festlv/eggbot/stls/Pen_Arm_Top.stl

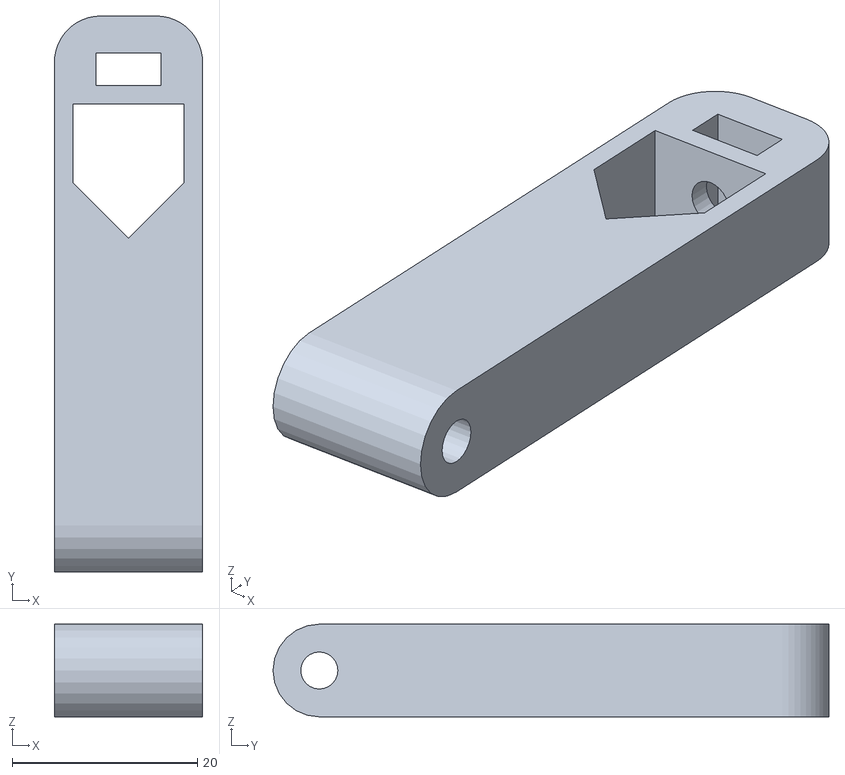
[picture p1: CAD file, 2014-04-03]
stls/Pen_Arm_Top.stl
16.0 x 60.0 x 10.0
