festlv/eggbot/stls/Pen_Arm_Pivot.stl

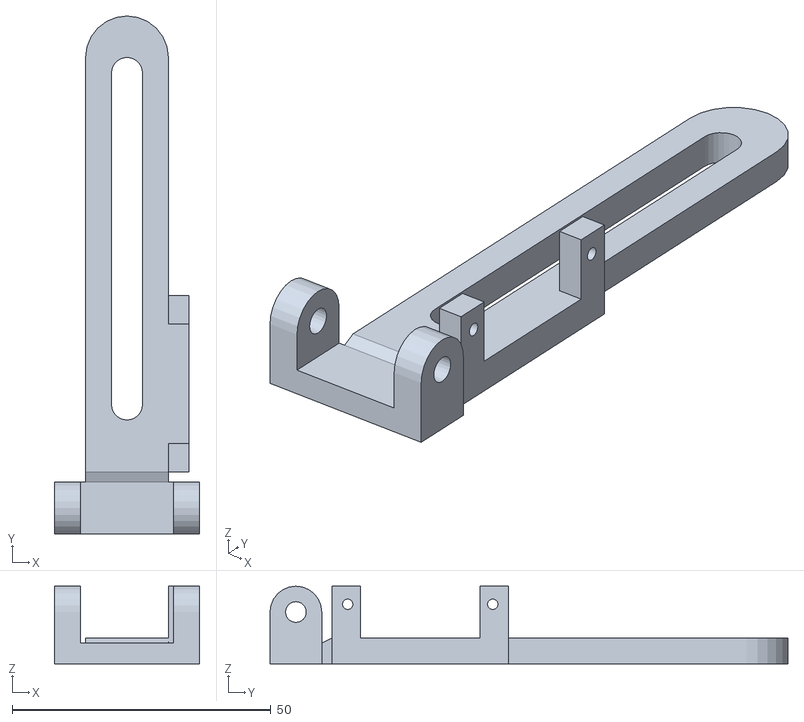
[picture p2: CAD file, 2014-04-03]
stls/Pen_Arm_Pivot.stl
28.0 x 100.0 x 15.0
