festlv/eggbot/stls/Idler_Bearing_Plate.stl

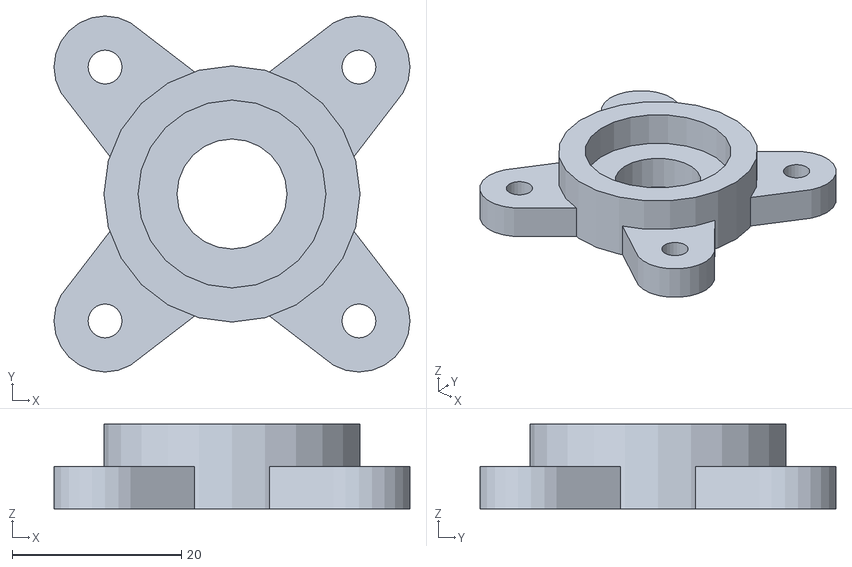
[picture p3: CAD file, 2014-04-03]
stls/Idler_Bearing_Plate.stl
42.1 x 42.1 x 10.0
