festlv/eggbot/stls/Idler_Knob.stl

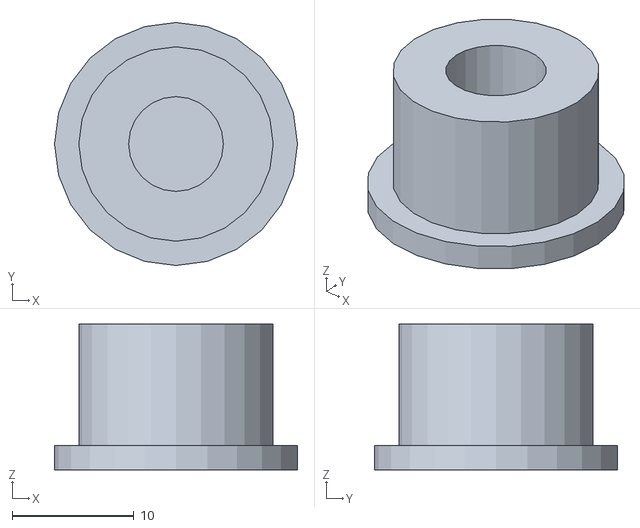
[picture p4: CAD file, 2014-04-03]
stls/Idler_Knob.stl
20.0 x 20.0 x 12.0
