festlv/eggbot/stls/Back_Plate.stl

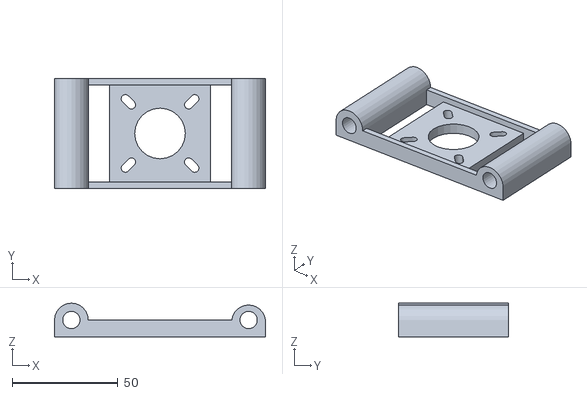
[picture p5: CAD file, 2014-04-03]
stls/Back_Plate.stl
100.0 x 52.0 x 16.0
