festlv/eggbot/stls/Egg_Cup_Idle.stl

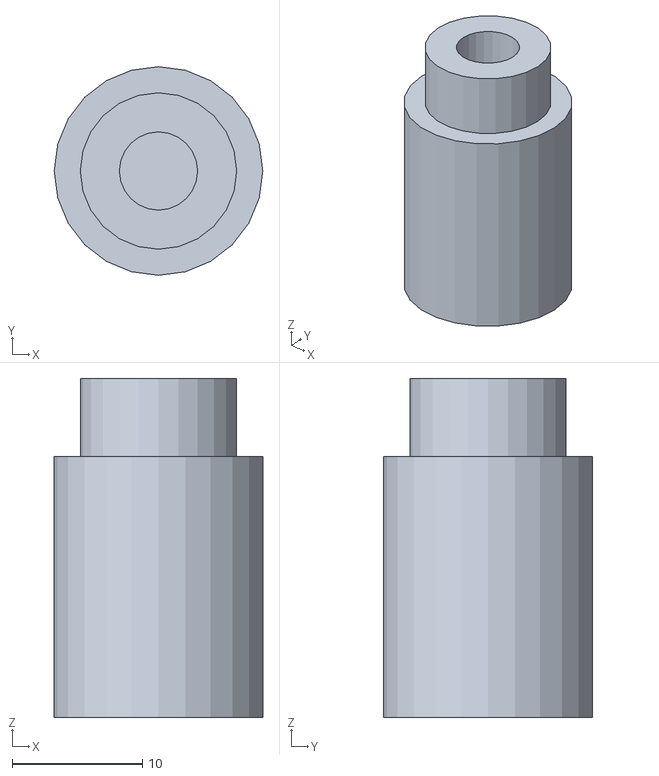
[picture p6: CAD file, 2014-04-03]
stls/Egg_Cup_Idle.stl
16.0 x 16.0 x 26.0
