festlv/eggbot/stls/Pen_Arm_Shaft_Coupler.stl

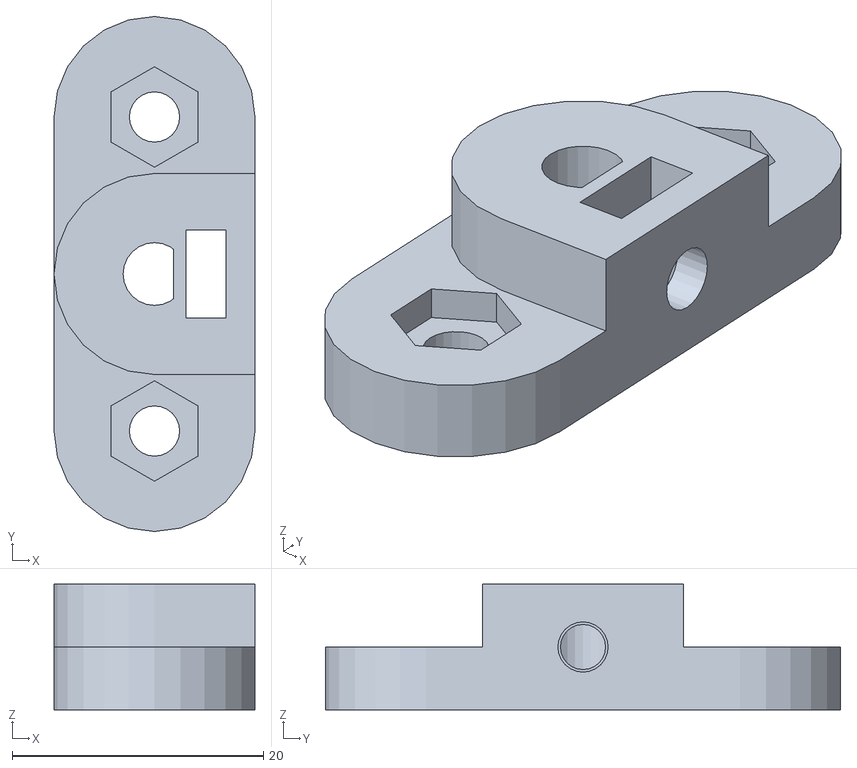
[picture p7: CAD file, 2014-04-03]
stls/Pen_Arm_Shaft_Coupler.stl
16.0 x 41.0 x 10.0
