festlv/eggbot/stls/End_Plate.stl

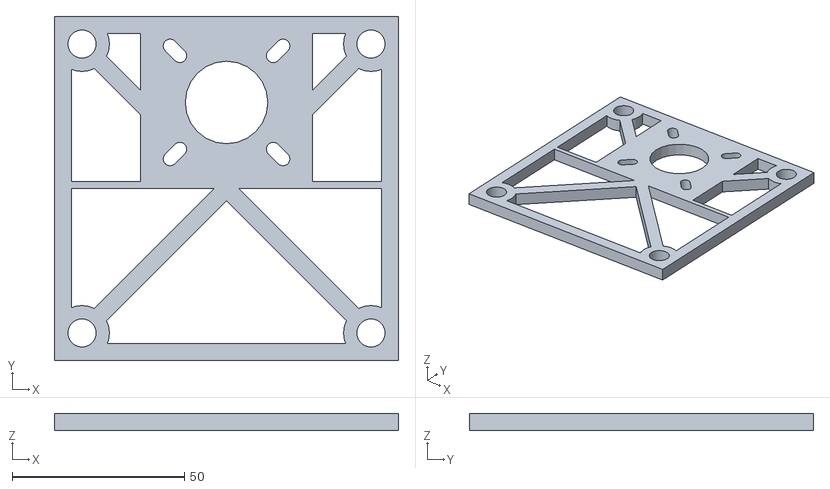
[picture p8: CAD file, 2014-04-03]
stls/End_Plate.stl
100.0 x 100.0 x 5.00
