festlv/eggbot/stls/Egg_Cup_Drive.stl

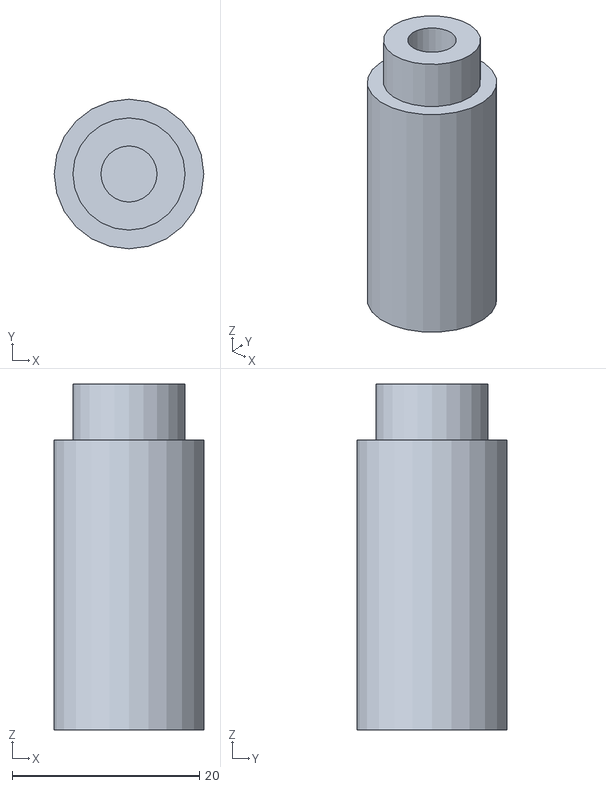
[picture p9: CAD file, 2014-04-03]
stls/Egg_Cup_Drive.stl
16.0 x 16.0 x 37.0
