festlv/eggbot/(list of files, cad)

Other CAD files:
stls/Back_Plate.skp
stls/Egg_Cup_Drive.skp
stls/Egg_Cup_Idle.skp
stls/End_Plate.skp
stls/Idler_Bearing_Plate.skp
stls/Idler_Knob.skp
stls/Pen_Arm_Pivot.skp
stls/Pen_Arm_Shaft_Coupler.skp
stls/Pen_Arm_Top.skp
