festlv/eggbot/hw/eggbot.pdf

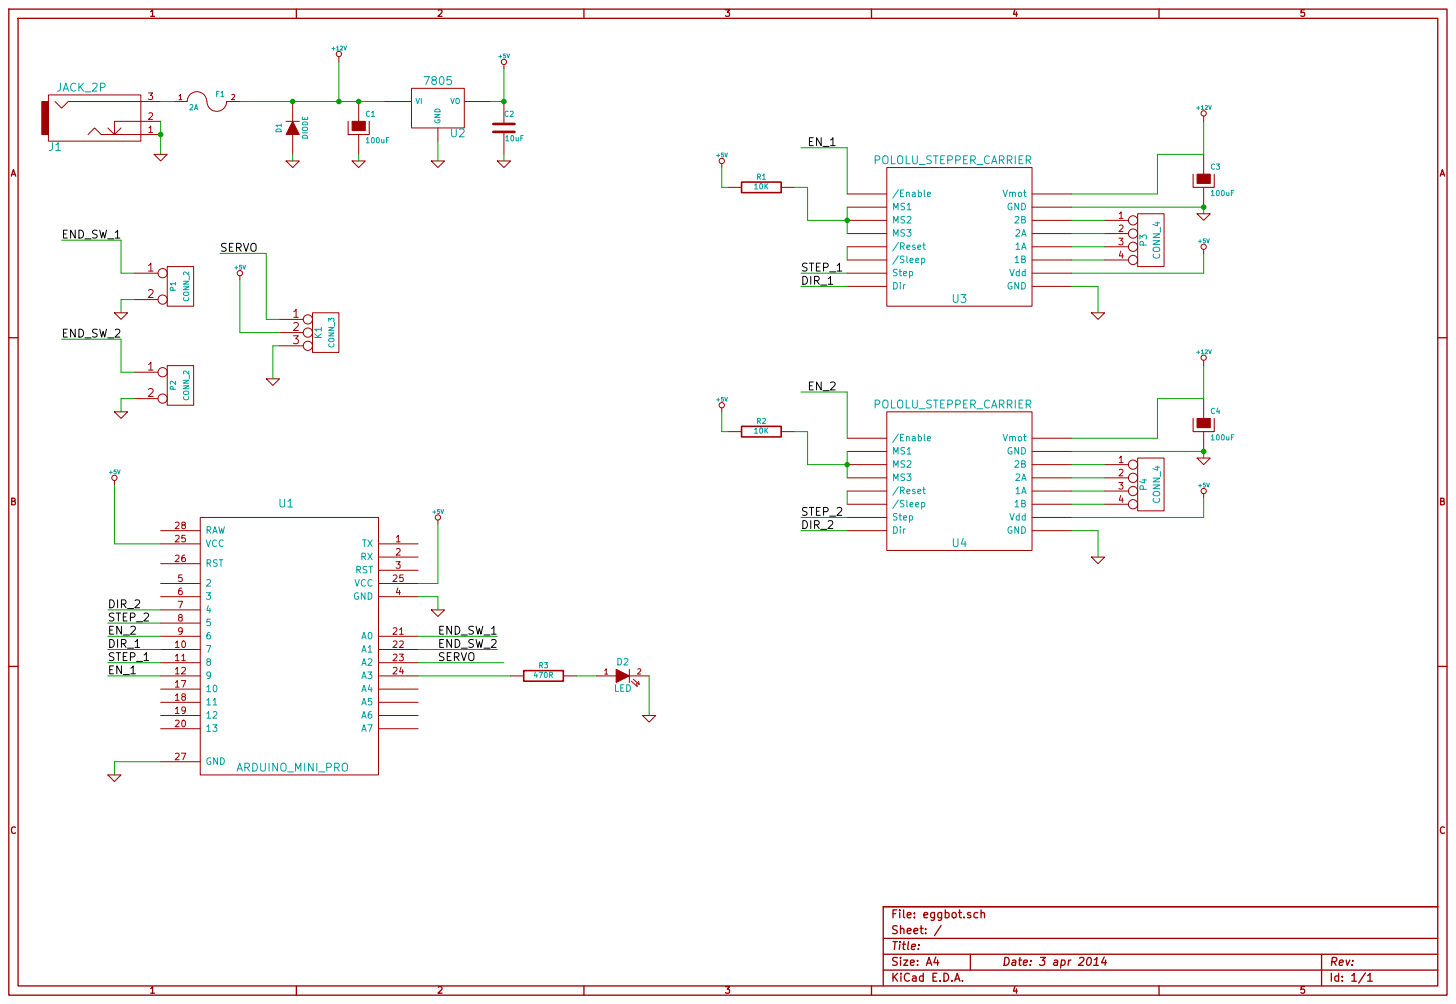
[picture p10: page 1]

Id: 1/1 Title: File: eggbot.sch
