festlv/eggbot/hw/eggbot.kicad_pcb

## KiCad design hw/eggbot.kicad_pcb (2014-04-08)

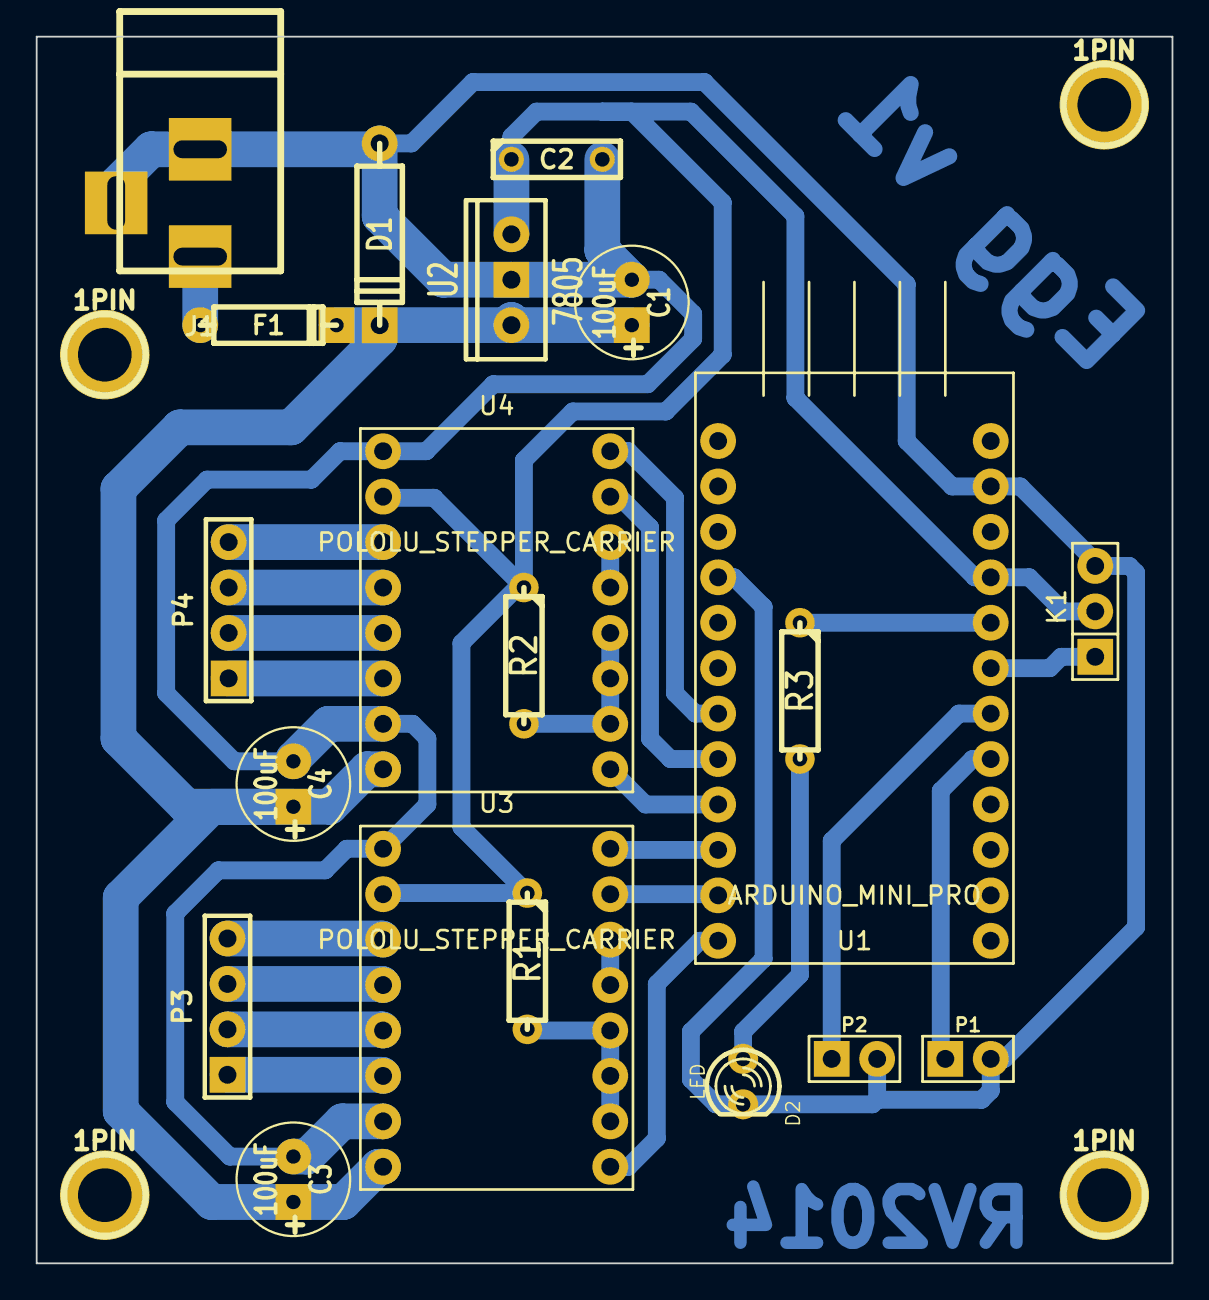
[picture p11: board eggbot.kicad_pcb from above]

Board: 2 copper layers, 63.5 x 68.6 mm, 24 parts (0 on the bottom side), 27 nets.

Parts:
1PIN, 1PIN#2, 1PIN#3, 1PIN#4: P***; 1pin
C1, C3, C4: 100uF; C1V7
C2: 10uF; C2
D1: DIODE; D4
D2: LED; LED-3MM
F1: 2A; D3
J1: JACK_2P; BARREL_JACK
K1: CONN_3; PIN_ARRAY_3X1
P1, P2: CONN_2; PIN_ARRAY_2X1
P3, P4: CONN_4; PIN_ARRAY_4x1
R1, R2: 10K; R3-LARGE_PADS
R3: 470R; R3-LARGE_PADS
U1: ARDUINO_MINI_PRO; ARDUINO_MINI
U2: 7805; LM78XXV
U3, U4: POLOLU_STEPPER_CARRIER; DRV8825_CARRIER

Connections:
+5V: C2.1, K1.2, R1.1, R2.1, U1.25, U2.VO, U3.10, U4.10
+12V: C1.1, C3.1, C4.1, D1.2, F1.2, U2.VI, U3.16, U4.16
/DIR_1: U1.10, U3.8
/DIR_2: U1.7, U4.8
/END_SW_1: P1.1, U1.21
/END_SW_2: P2.1, U1.22
/EN_1: U1.12, U3.1
/EN_2: U1.9, U4.1
/SERVO: K1.1, U1.23
/STEP_1: U1.11, U3.7
/STEP_2: U1.8, U4.7
GND: C1.2, C2.2, C3.2, C4.2, D1.1, D2.2, J1.1, J1.2, K1.3, P1.2, P2.2, U1.4, U1.27, U2.GND, U3.9, U3.15, U4.9, U4.15
unnamed: R1.2, U3.2, U3.3, U3.4
unnamed: U4.5, U4.6
unnamed: U3.5, U3.6
unnamed: R2.2, U4.2, U4.3, U4.4
unnamed: R3.1, U1.24
unnamed: D2.1, R3.2
unnamed: P4.1, U4.14
unnamed: P4.2, U4.13
unnamed: P4.3, U4.12
unnamed: P4.4, U4.11
unnamed: F1.1, J1.3
unnamed: P3.3, U3.12
unnamed: P3.4, U3.11
unnamed: P3.2, U3.13
unnamed: P3.1, U3.14
