festlv/eggbot/fw/src/sketch.ino

/* -*- coding: utf-8 -*- */

/*
 * Copyright 2011 by Eberhard Rensch <http://pleasantsoftware.com/developer/3d>
 *
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
 * Part of this code is based on/inspired by the Helium Frog Delta Robot Firmware
 * by Martin Price <http://www.HeliumFrog.com>
 *
 * !!!!!!!!
 * This sketch needs the following non-standard libraries (install them in the Arduino library directory):
 * SoftwareServo: http://www.arduino.cc/playground/ComponentLib/Servo
 * TimerOne: http://www.arduino.cc/playground/Code/Timer1
 * !!!!!!!!
 */

#include <TimerOne.h>
#include <SoftwareServo.h>
#include <StepperModel.h>

void doInterrupt();
void commitSteppers(double speedrate);
void get_command();
void clear_buffer();
boolean getValue(char key, char command[], double* value);
void process_commands(char command[], int command_length);
void drawArc(double centerX, double centerY, double endpointX, double endpointY, boolean clockwise);


#define TIMER_DELAY 64

/*
 * PINS
 */
 
#define XAXIS_DIR_PIN 7
#define XAXIS_STEP_PIN 8
#define XAXIS_ENABLE_PIN 9
#define XAXIS_ENDSTOP_PIN -1
const int XAXIS_STEP_PER_REVOLUTION = 200 * 16; //  360° / 1.8 °/step = 200

#define YAXIS_DIR_PIN 4
#define YAXIS_STEP_PIN 5
#define YAXIS_ENABLE_PIN 6
#define YAXIS_ENDSTOP_PIN -1 // <0 0> No Endstop
const int YAXIS_STEP_PER_REVOLUTION = 200*16;
#define SERVO_PIN A2

/*
 * Other Configuration
 */

#define DEFAULT_PEN_UP_POSITION 45
#define XAXIS_MIN_STEPCOUNT 0
#define XAXIS_MAX_STEPCOUNT 0
#define DEFAULT_ZOOM_FACTOR 1.0 // Zoom factor based on 1 px = 1 step gcode must be in px aka step (not mm)
                               // The zoom factor can be also manipulated by the propretiary code M402


/* --------- */

StepperModel xAxisStepper(XAXIS_DIR_PIN, XAXIS_STEP_PIN, XAXIS_ENABLE_PIN, XAXIS_ENDSTOP_PIN,
        XAXIS_MIN_STEPCOUNT, XAXIS_MAX_STEPCOUNT, XAXIS_STEP_PER_REVOLUTION, 16);

StepperModel rotationStepper(YAXIS_DIR_PIN, YAXIS_STEP_PIN, YAXIS_ENABLE_PIN, YAXIS_ENDSTOP_PIN,
        0, 0, YAXIS_STEP_PER_REVOLUTION, 16);

SoftwareServo servo;
boolean servoEnabled=true;

long intervals=0;
volatile long intervals_remaining=0;
volatile boolean isRunning=false;

// comm variables
const int MAX_CMD_SIZE = 256;
char buffer[MAX_CMD_SIZE]; // buffer for serial commands
//char serial_char; // value for each byte read in from serial comms
int serial_count = 0; // current length of command
char *strchr_pointer; // just a pointer to find chars in the cmd string like X, Y, Z, E, etc
boolean comment_mode = false;
// end comm variables

// GCode States
double currentOffsetX = 0.;
double currentOffsetY = 0.;
boolean absoluteMode = true;
double feedrate = 2000.; // mm/minute
double zoom = DEFAULT_ZOOM_FACTOR;

const double maxFeedrate = 6000.;
// ------

void setup()
{
    Serial.begin(115200);
    /* Serial.begin(9600); */

    clear_buffer();

    servo.attach(SERVO_PIN);
    servo.write(DEFAULT_PEN_UP_POSITION);

    if(servoEnabled)
    {
      for(int i=0;i<100;i++)
      {
          SoftwareServo::refresh();
          delay(4);
      }
    }
    
    //--- Activate the PWM timer
    Timer1.initialize(TIMER_DELAY); // Timer for updating pwm pins
    Timer1.attachInterrupt(doInterrupt);
  
#ifdef AUTO_HOMING
    xAxisStepper.autoHoming();
    xAxisStepper.setTargetPosition(0.);
    commitSteppers(maxFeedrate);
    delay(2000);
    xAxisStepper.enableStepper(false);
#endif
    Serial.println("ready ok:");
}

void loop() // input loop, looks for manual input and then checks to see if and serial commands are coming in
{
  get_command(); // check for Gcodes
  if(servoEnabled)
    SoftwareServo::refresh();
}

//--- Interrupt-Routine: Move the steppers
void doInterrupt()
{
  if(isRunning)
  {
      if (intervals_remaining-- == 0)
	 isRunning = false;
      else
      {
          rotationStepper.doStep(intervals);
          xAxisStepper.doStep(intervals);
      }
  }
}

void commitSteppers(double speedrate)
{
  long deltaStepsX = xAxisStepper.delta;
  if(deltaStepsX != 0L)
  {
    xAxisStepper.enableStepper(true);
  }

  long deltaStepsY = rotationStepper.delta;
  if(deltaStepsY != 0L)
  {
    rotationStepper.enableStepper(true);
  }
  long masterSteps = (deltaStepsX>deltaStepsY)?deltaStepsX:deltaStepsY;

  double deltaDistanceX = xAxisStepper.targetPosition-xAxisStepper.getCurrentPosition();
  double deltaDistanceY = rotationStepper.targetPosition-rotationStepper.getCurrentPosition();
  		
  // how long is our line length?
  double distance = sqrt(deltaDistanceX*deltaDistanceX+deltaDistanceY*deltaDistanceY);
		  	  
  // compute number of intervals for this move
  double sub1 = (60000.* distance / speedrate);
  double sub2 = sub1 * 1000.;
  intervals = (long)sub2/TIMER_DELAY;

  intervals_remaining = intervals;
  const long negative_half_interval = -intervals / 2;
  
  rotationStepper.counter = negative_half_interval;
  xAxisStepper.counter = negative_half_interval;

 /* Serial.print("Speedrate:"); */
 /* Serial.print(speedrate, 6); */
 /* Serial.print(" dX:"); */
 /* Serial.print(deltaStepsX); */
 /* Serial.print(" dY:"); */
 /* Serial.print(deltaStepsY); */
 /* Serial.print(" masterSteps:"); */
 /* Serial.print(masterSteps); */
 /* Serial.print(" dDistX:"); */
 /* Serial.print(deltaDistanceX); */
 /* Serial.print(" dDistY:");	 */
 /* Serial.print(deltaDistanceY); */
 /* Serial.print(" distance:"); */
 /* Serial.print(distance); */
 /* Serial.print(" sub1:"); */
 /* Serial.print(sub1, 6); */
 /* Serial.print(" sub2:"); */
 /* Serial.print(sub2, 6); */
 /* Serial.print(" intervals:"); */
 /* Serial.print(intervals); */
 /* Serial.print(" negative_half_interval:"); */
 /* Serial.println(negative_half_interval); */
 /* Serial.print("Y currentStepCount:"); */
 /* Serial.print(rotationStepper.currentStepcount); */
 /* Serial.print(" targetStepCount:"); */
 /* Serial.println(rotationStepper.targetStepcount); */

  isRunning=true;
}

void get_command() // gets commands from serial connection and then calls up subsequent functions to deal with them
{
  if (!isRunning && Serial.available() > 0) // each time we see something
  {
    char serial_char = char(Serial.read()); // read individual byte from serial connection
    if (serial_char == 13 || serial_char == 10 || serial_char == 244
        || serial_char == '\n' || serial_char == '\r' || serial_char == '\r\n') // end of a command character
    {
      buffer[serial_count]=0;
      process_commands(buffer, serial_count);
      clear_buffer();
      comment_mode = false; // reset comment mode before each new command is processed
    }
    else // not end of command
    {
      if (serial_char == ';' || serial_char == '(') // semicolon signifies start of comment
      {
        comment_mode = true;
      }
      
      if (comment_mode != true) // ignore if a comment has started
      {
        buffer[serial_count] = serial_char; // add byte to buffer string
        serial_count++;
        if (serial_count > MAX_CMD_SIZE) // overflow, dump and restart
        {
          clear_buffer();
          Serial.flush();
        }
      }
    }
  }
}

void clear_buffer() // empties command buffer from serial connection
{
  serial_count = 0; // reset buffer placement
}

boolean getValue(char key, char command[], double* value)
{  
  // find key parameter
  strchr_pointer = strchr(buffer, key);
  if (strchr_pointer != NULL) // We found a key value
  {
    *value = (double)strtod(&command[strchr_pointer - command + 1], NULL);
    return true;  
  }
  return false;
}

void process_commands(char command[], int command_length) // deals with standardized input from serial connection
{
  if (command_length>0 && command[0] == 'G') // G code
  {
    int codenum = (int)strtod(&command[1], NULL);
    
    double tempX = xAxisStepper.getCurrentPosition();
    double tempY = rotationStepper.getCurrentPosition();
    
    double xVal;
    boolean hasXVal = getValue('X', command, &xVal);
    if(hasXVal) xVal*=zoom;
    double yVal;
    boolean hasYVal = getValue('Y', command, &yVal);
    if(hasYVal) yVal*=zoom;
    double iVal;
    boolean hasIVal = getValue('I', command, &iVal);
    if(hasIVal) iVal*=zoom;
    double jVal;
    boolean hasJVal = getValue('J', command, &jVal);
    if(hasJVal) jVal*=zoom;
    double rVal;
    boolean hasRVal = getValue('R', command, &rVal);
    if(hasRVal) rVal*=zoom;
    double pVal;
    boolean hasPVal = getValue('P', command, &pVal);
    
    getValue('F', command, &feedrate);

    xVal+=currentOffsetX;
    yVal+=currentOffsetY;
    
    if(absoluteMode)
    {
      if(hasXVal)
        tempX=xVal;
      if(hasYVal)
        tempY=yVal;
    }
    else
    {
      if(hasXVal)
        tempX+=xVal;
      if(hasYVal)
        tempY+=yVal;
    }
    
    switch(codenum)
    {
      case 0: // G0, Rapid positioning
        xAxisStepper.setTargetPosition(tempX);
        rotationStepper.setTargetPosition(tempY);
        commitSteppers(maxFeedrate);
        break;
      case 1: // G1, linear interpolation at specified speed
        xAxisStepper.setTargetPosition(tempX);
        rotationStepper.setTargetPosition(tempY);
        commitSteppers(feedrate);
        break;
      case 2: // G2, Clockwise arc
      case 3: // G3, Counterclockwise arc
        if(hasIVal && hasJVal)
        {
            double centerX=xAxisStepper.getCurrentPosition()+iVal;
            double centerY=rotationStepper.getCurrentPosition()+jVal;
            drawArc(centerX, centerY, tempX, tempY, (codenum==2));
        }
        else if(hasRVal)
        {
          //drawRadius(tempX, tempY, rVal, (codenum==2));
        }
        break;
      case 4: // G4, Delay P ms
        if(hasPVal)
        {
           unsigned long endDelay = millis()+ (unsigned long)pVal;
           while(millis()<endDelay)
           {
              delay(1);
              if(servoEnabled)
                SoftwareServo::refresh();
           }
        }
        break;
      case 90: // G90, Absolute Positioning
        absoluteMode = true;
        break;
      case 91: // G91, Incremental Positioning
        absoluteMode = false;
        break;
    }
  }  
  else if (command_length>0 && command[0] == 'M') // M code
  {
    double value;
    int codenum = (int)strtod(&command[1], NULL);

    uint8_t prev_servo_value;

    switch(codenum)
    {   
      case 18: // Disable Drives
        xAxisStepper.resetStepper();
        rotationStepper.resetStepper();
        break;

      case 300: // Servo Position
        if(getValue('S', command, &value))
        {
          servoEnabled=true;
          if(value<0.)
            value=0.;
          else if(value>180.)
          {
            value=DEFAULT_PEN_UP_POSITION;
            servo.write((int)value);
            for(int i=0;i<100;i++)
            {
                SoftwareServo::refresh();
                delay(4);
            }           
            servoEnabled=false;
          }
            prev_servo_value = servo.read();
            if ((value - prev_servo_value) > 0) {
                //split the movement range in 5 intervals with 20ms delay between them
                while (servo.read() < value) {
                    servo.write(servo.read() + (value - prev_servo_value)/10);
                    SoftwareServo::refresh();
                    delay(50);
                }
            } else {
                while (servo.read() > value) {
                    servo.write(servo.read() - (prev_servo_value - value)/5);
                    SoftwareServo::refresh();
                    delay(40);
                }

            }
        }
        break;
        
      case 400: // Propretary: Reset X-Axis-Stepper settings to new object diameter
        if(getValue('S', command, &value))
        {
          xAxisStepper.resetSteppersForObjectDiameter(value);
          xAxisStepper.setTargetPosition(0.);
          commitSteppers(maxFeedrate);
          delay(2000);
          xAxisStepper.enableStepper(false);
        }
        break;
        
      case 401: // Propretary: Reset Y-Axis-Stepper settings to new object diameter
        if(getValue('S', command, &value))
        {
          rotationStepper.resetSteppersForObjectDiameter(value);
          rotationStepper.setTargetPosition(0.);
          commitSteppers(maxFeedrate);
          delay(2000);
          rotationStepper.enableStepper(false);
        }
        break;
        
       case 402: // Propretary: Set global zoom factor
        if(getValue('S', command, &value))
        {
          zoom = value;
        }

    }
  }  

  // done processing commands
  if (Serial.available() <= 0) {
    Serial.print("ok:");
    Serial.println(command);
  }
}

/* This code was ported from the Makerbot/ReplicatorG java sources */
void drawArc(double centerX, double centerY, double endpointX, double endpointY, boolean clockwise) 
{
  // angle variables.
  double angleA;
  double angleB;
  double angle;
  double radius;
  double length;

  // delta variables.
  double aX;
  double aY;
  double bX;
  double bY;

  // figure out our deltas
  double currentX = xAxisStepper.getCurrentPosition();
  double currentY = rotationStepper.getCurrentPosition();
  aX = currentX - centerX;
  aY = currentY - centerY;
  bX = endpointX - centerX;
  bY = endpointY - centerY;

  // Clockwise
  if (clockwise) {
    angleA = atan2(bY, bX);
    angleB = atan2(aY, aX);
  }
  // Counterclockwise
  else {
    angleA = atan2(aY, aX);
    angleB = atan2(bY, bX);
  }

  // Make sure angleB is always greater than angleA
  // and if not add 2PI so that it is (this also takes
  // care of the special case of angleA == angleB,
  // ie we want a complete circle)
  if (angleB <= angleA)
    angleB += 2. * M_PI;
  angle = angleB - angleA;
		
  // calculate a couple useful things.
  radius = sqrt(aX * aX + aY * aY);
  length = radius * angle;

  // for doing the actual move.
  int steps;
  int s;
  int step;

  // Maximum of either 2.4 times the angle in radians
  // or the length of the curve divided by the curve section constant
  steps = (int)ceil(max(angle * 2.4, length));

  // this is the real draw action.
  double newPointX = 0.;
  double newPointY = 0.;
  
  for (s = 1; s <= steps; s++) {
    // Forwards for CCW, backwards for CW
    if (!clockwise)
	step = s;
    else
	step = steps - s;

    // calculate our waypoint.
    newPointX = centerX + radius * cos(angleA + angle * ((double) step / steps));
    newPointY= centerY + radius	* sin(angleA + angle * ((double) step / steps));

    // start the move
    xAxisStepper.setTargetPosition(newPointX);
    rotationStepper.setTargetPosition(newPointY);
    commitSteppers(feedrate);
    
    while(isRunning)
    {
      delay(1);
      if(servoEnabled)
        SoftwareServo::refresh();
    };
  }
}

/* Make life easier for vim users */
/* vim:set filetype=cpp: */
