festlv/eggbot/(commit log)

2014-04-03 Committing G-code for milling PCB
2014-04-08 Latest revision of schematics
    [eggbot.kicad_pcb, eggbot.sch]
2014-10-28 Added schematics
2014-10-28 Made servo movements smoother
